pvico/RX-Dual-Power/Additional Documents/img/PCB Design Bottom.png

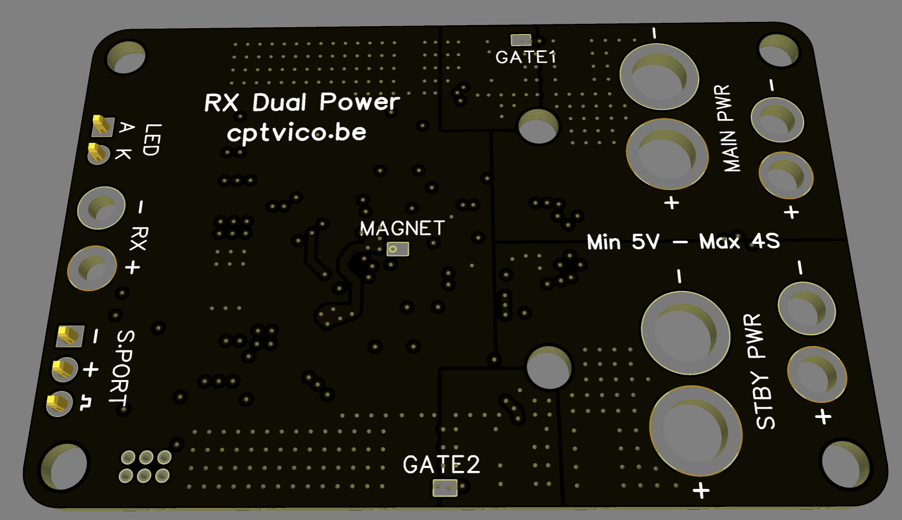
Additional Documents/img/PCB Design Bottom.png
