pvico/RX-Dual-Power/Additional Documents/img/PCB Design Top.png

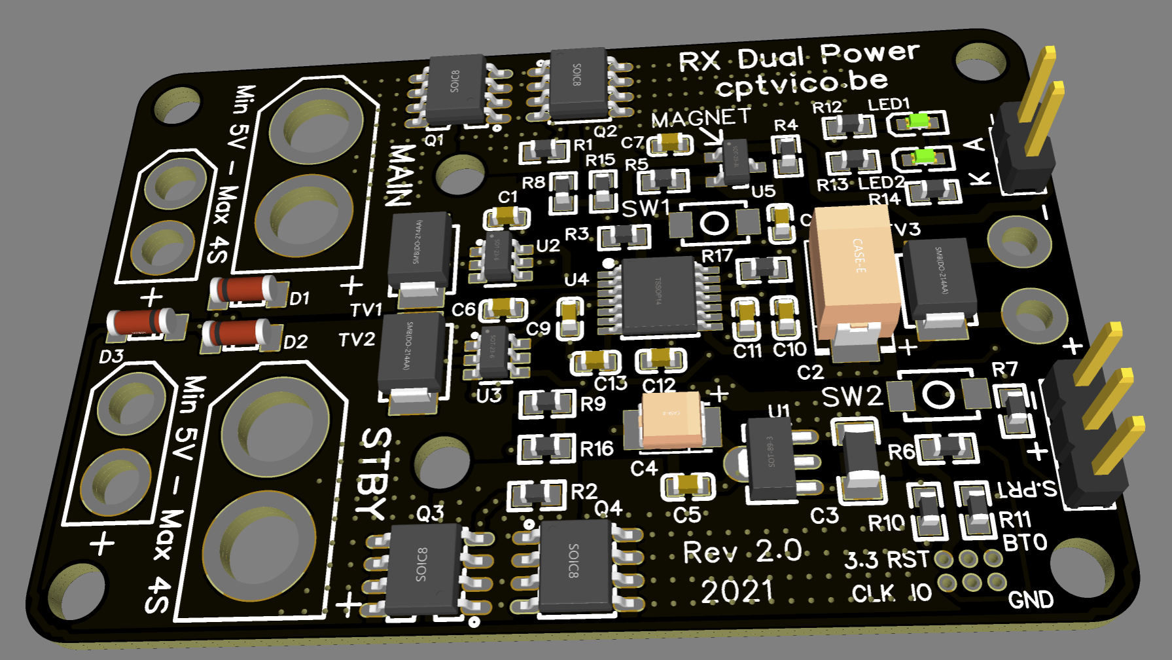
Additional Documents/img/PCB Design Top.png
