pvico/RX-Dual-Power/Additional Documents/img/RX Dual Power Back.jpg

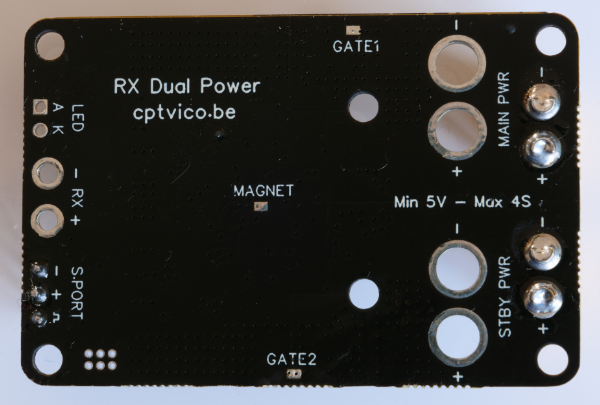
Additional Documents/img/RX Dual Power Back.jpg
