pvico/RX-Dual-Power/TODO.md

# TODO

- Configuration programming through usart
- Organize README and move part of it to wiki (https://guides.github.com/features/wikis/)

### Optional

- UART auto baudrate
- Other protocols:
    - SBUS2 (Futaba)
    - X-BUS (Spektrum)
    - M-LINK (Multiplex)
    - EX Bus (Jeti)
    - iBUS (FlySky)
