pvico/RX-Dual-Power/RISK-ANALYSIS.md

# TBD

## Electronics risks

## Software risks
