pvico/RX-Dual-Power/Additional Documents/pdf/Schematic.pdf

# 3.3V Regulator

Battery/BEC Connectors | Switches & Driver

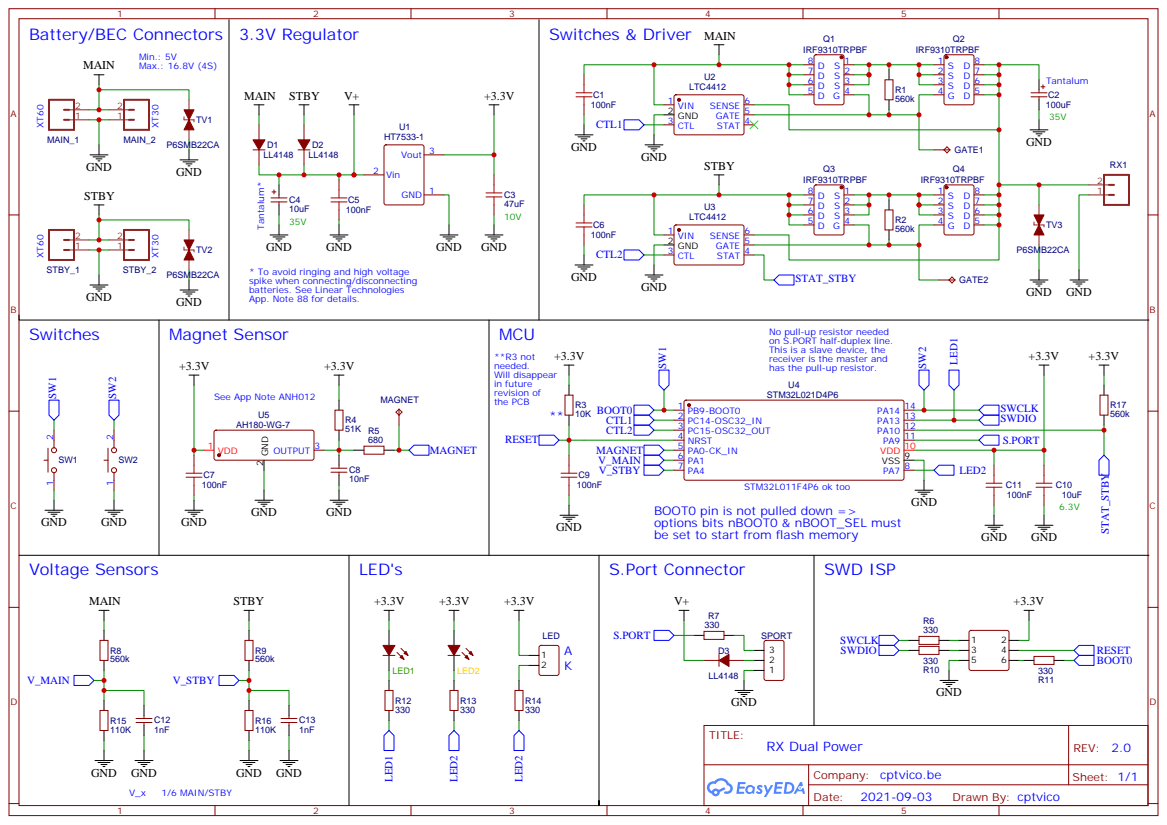
[picture p8: page 1]

* To avoid ringing and high voltage
spike when connecting/disconnecting
batteries. See Linear Technologies
App. Note 88 for details.

No pull-up resistor needed
on S.PORT half-duplex line.
This is a slave device, the
receiver is the master and
has the pull-up resistor.
STM32L021D4P6

MAGNET See App Note ANH012

BOOT0 pin is not pulled down =>
options bits nBOOT0 & nBOOT_SEL must
be set to start from flash memory
