pvico/RX-Dual-Power/Core/Inc/main.h

#define SW1_Pin LL_GPIO_PIN_9
#define SW1_GPIO_Port GPIOB
#define CTL1_Pin LL_GPIO_PIN_14
#define CTL1_GPIO_Port GPIOC
#define CTL2_Pin LL_GPIO_PIN_15
#define CTL2_GPIO_Port GPIOC
#define MAGNET_Pin LL_GPIO_PIN_0
#define MAGNET_GPIO_Port GPIOA
#define MAGNET_EXTI_IRQn EXTI0_1_IRQn
#define V_MAIN_Pin LL_GPIO_PIN_1
#define V_MAIN_GPIO_Port GPIOA
#define V_STBY_Pin LL_GPIO_PIN_4
#define V_STBY_GPIO_Port GPIOA
#define LED2_Pin LL_GPIO_PIN_7
#define LED2_GPIO_Port GPIOA
#define S_PORT_Pin LL_GPIO_PIN_9
#define S_PORT_GPIO_Port GPIOA
#define STAT_STBY_Pin LL_GPIO_PIN_10
#define STAT_STBY_GPIO_Port GPIOA
#define LED1_Pin LL_GPIO_PIN_13
#define LED1_GPIO_Port GPIOA
#define SW2_Pin LL_GPIO_PIN_14
#define SW2_GPIO_Port GPIOA
#define NVIC_PRIORITYGROUP_0         ((uint32_t)0x00000007) /*!< 0 bit  for pre-emption priority,
#define NVIC_PRIORITYGROUP_1         ((uint32_t)0x00000006) /*!< 1 bit  for pre-emption priority,
#define NVIC_PRIORITYGROUP_2         ((uint32_t)0x00000005) /*!< 2 bits for pre-emption priority,
#define NVIC_PRIORITYGROUP_3         ((uint32_t)0x00000004) /*!< 3 bits for pre-emption priority,
#define NVIC_PRIORITYGROUP_4         ((uint32_t)0x00000003) /*!< 4 bits for pre-emption priority,
