pvico/RX-Dual-Power/Inc/main_loop.h

//######################################################################################
// main_loop.h
// Main loop code, executes in an infinite loop after initialization
//
// Philippe Vico - 2021
//######################################################################################
 

#ifndef BF39E1DF_84AD_43F1_B73F_682AE7BE173E
#define BF39E1DF_84AD_43F1_B73F_682AE7BE173E


void main_loop();


#endif /* BF39E1DF_84AD_43F1_B73F_682AE7BE173E */
