pvico/RX-Dual-Power/Inc/exbus.h

//######################################################################################
// exbus.h
// Telemetry interface for EX Bus protocol (Jeti)
//
// Philippe Vico - 2021
//######################################################################################
 
 
#ifndef BC8CD575_174A_434F_92E2_CE01267D538C
#define BC8CD575_174A_434F_92E2_CE01267D538C


#include "main.h"
#include "initialize.h"


// FUTURE DEV



#endif /* BC8CD575_174A_434F_92E2_CE01267D538C */
