pvico/RX-Dual-Power/Src/exbus.c

//######################################################################################
// exbus.c
// Telemetry interface for EX Bus protocol (Jeti)
//
// Philippe Vico - 2021
//######################################################################################
 
 
#include "exbus.h"


// FUTURE DEV




//############################### Local helper functions ###############################
 
//######################################################################################
 
 
//################################## Public functions ##################################
 
//######################################################################################
 
 
//################################ Callback functions ##################################
 
//######################################################################################
