pvico/RX-Dual-Power/Src/ibus.c

//######################################################################################
// ibus.c
// Telemetry interface for X-BUS protocol (Spektrum)
//
// Philippe Vico - 2021
//######################################################################################
 
 
#include "ibus.h"


// FUTURE DEV




//############################### Local helper functions ###############################
 
//######################################################################################
 
 
//################################## Public functions ##################################
 
//######################################################################################
 
 
//################################ Callback functions ##################################
 
//######################################################################################
