pvico/RX-Dual-Power/Inc/system_clock.h

//######################################################################################
// system_clock.h
// Initialization of the system clocks
//
// Philippe Vico - 2021
//######################################################################################


#ifndef B3B07BC2_B140_48BF_953B_561AC0EC74BB
#define B3B07BC2_B140_48BF_953B_561AC0EC74BB


void init_system_clock();


#endif /* B3B07BC2_B140_48BF_953B_561AC0EC74BB */
