pvico/RX-Dual-Power/Src/m-link.c

//######################################################################################
// m-link.c
// Telemetry interface for M-LINK protocol (Multpiplex)
//
// Philippe Vico - 2021
//######################################################################################
 
 
#include "m-link.h"


// FUTURE DEV




//############################### Local helper functions ###############################
 
//######################################################################################
 
 
//################################## Public functions ##################################
 
//######################################################################################
 
 
//################################ Callback functions ##################################
 
//######################################################################################
