pvico/RX-Dual-Power/Src/sbus2.c

//######################################################################################
// sbus2.c
// Telemetry interface for SBUS2 protocol (Futaba)
//
// Philippe Vico - 2021
//######################################################################################
 
 
#include "sbus2.h"


// FUTURE DEV




//############################### Local helper functions ###############################
 
//######################################################################################
 
 
//################################## Public functions ##################################
 
//######################################################################################
 
 
//################################ Callback functions ##################################
 
//#######################################################################################
