pvico/RX-Dual-Power/Src/system_clock.c

//######################################################################################
// system_clock.c
// Initialization of the system clocks
//
// Philippe Vico - 2021
//######################################################################################


#include "system_clock.h"
#include "main.h"


//############################### Local helper functions ###############################

void init_system_clock() {
  LL_FLASH_SetLatency(LL_FLASH_LATENCY_0);
  while(LL_FLASH_GetLatency()!= LL_FLASH_LATENCY_0) {}
  LL_PWR_SetRegulVoltageScaling(LL_PWR_REGU_VOLTAGE_SCALE1);
  LL_RCC_HSI_Enable();

   /* Wait till HSI is ready */
  while(LL_RCC_HSI_IsReady() != 1) {}
  LL_RCC_HSI_SetCalibTrimming(16);
  LL_RCC_PLL_ConfigDomain_SYS(LL_RCC_PLLSOURCE_HSI, LL_RCC_PLL_MUL_3, LL_RCC_PLL_DIV_3);
  LL_RCC_PLL_Enable();

   /* Wait till PLL is ready */
  while(LL_RCC_PLL_IsReady() != 1) {}
  LL_RCC_SetAHBPrescaler(LL_RCC_SYSCLK_DIV_1);
  LL_RCC_SetAPB1Prescaler(LL_RCC_APB1_DIV_1);
  LL_RCC_SetAPB2Prescaler(LL_RCC_APB2_DIV_1);
  LL_RCC_SetSysClkSource(LL_RCC_SYS_CLKSOURCE_PLL);

   /* Wait till System clock is ready */
  while(LL_RCC_GetSysClkSource() != LL_RCC_SYS_CLKSOURCE_STATUS_PLL) {}

  LL_Init1msTick(16000000);

  LL_SetSystemCoreClock(16000000);
  LL_RCC_SetUSARTClockSource(LL_RCC_USART2_CLKSOURCE_PCLK1);
}
