pvico/RX-Dual-Power/Inc/system.h

//######################################################################################
// system.h
// Determines power off activation and some timing functiopns
//
// Philippe Vico - 2021
//######################################################################################


#ifndef BD480334_5D6E_4ECD_90B7_42EA759C3902
#define BD480334_5D6E_4ECD_90B7_42EA759C3902


#include <stdbool.h>


void system_loop();
bool is_in_first_16s_after_startup();
bool is_in_first_32s_after_startup();
bool rough_second_tick();
bool rough_quarter_second_tick();


#endif /* BD480334_5D6E_4ECD_90B7_42EA759C3902 */
