pvico/RX-Dual-Power/Inc/timer.h

//######################################################################################
// timer.h
// Timer initializaton
//
// Philippe Vico - 2021
//######################################################################################


#ifndef FC128E11_9435_48CF_9FB7_F27F441DEDFA
#define FC128E11_9435_48CF_9FB7_F27F441DEDFA


void init_timer();


#endif /* FC128E11_9435_48CF_9FB7_F27F441DEDFA */
