pvico/RX-Dual-Power/Inc/watchdog.h

//######################################################################################
// watchdog.c
// Initialization of watchdog
//
// Philippe Vico - 2021
//######################################################################################


#ifndef E8358196_CFBC_4A72_951B_5523CD6C785E
#define E8358196_CFBC_4A72_951B_5523CD6C785E


void init_watchdog();


#endif /* E8358196_CFBC_4A72_951B_5523CD6C785E */
