pvico/RX-Dual-Power/Inc/adc_dma.h

//######################################################################################
// adc_dma.h
// Initialization and interrupt callback functions for ADC and DMA
//
// Philippe Vico - 2021
//######################################################################################


#ifndef A761D1B1_EFD4_4E28_91EE_EBCC86E26999
#define A761D1B1_EFD4_4E28_91EE_EBCC86E26999


void init_adc_dma();

void dma_callback();
void adc_callback();


#endif /* A761D1B1_EFD4_4E28_91EE_EBCC86E26999 */
