pvico/RX-Dual-Power/Inc/button.h

//######################################################################################
// button.h
// Intitialization and loop code for buttons and managament of button state 
//
// Philippe Vico - 2021
//######################################################################################


#ifndef A61822EC_01F4_46DB_9C40_C645C11613D2
#define A61822EC_01F4_46DB_9C40_C645C11613D2

#include "stdbool.h"
#include "stdint.h"
#include "initialize.h"

#define BUTTON_DEBOUNCE_DELAY_MILLIS    10
#define BUTTON_DOUBLE_ACTIVATION_MILLIS    2000

typedef enum button_states {BUTTON_DEPRESSED, BUTTON_NOT_DEPRESSED} button_state;
typedef enum {SW1, SW2} button_name;


typedef struct {
    button_state debounced_state;
    uint16_t depressed_loop_counter;
    uint16_t not_depressed_loop_counter;
    bool (*is_depressed)(void);
} button;


initialization_result init_buttons();

void button_loop();

bool is_button_dual_activation_active();

#endif /* A61822EC_01F4_46DB_9C40_C645C11613D2 */
