pvico/RX-Dual-Power/Inc/initialize.h

//######################################################################################
// initialize.c
// All initialization before entering the main loop
//
// Philippe Vico - 2021
//######################################################################################


#ifndef F5452735_251A_4D3E_9219_05E1BA3BC45C
#define F5452735_251A_4D3E_9219_05E1BA3BC45C


typedef enum initialization_results {INITIALIZE_OK, INITIALIZE_NOT_OK} initialization_result;


void initialize();


#endif /* F5452735_251A_4D3E_9219_05E1BA3BC45C */
