pvico/RX-Dual-Power/Inc/m-link.h

//######################################################################################
// m-link.h
// Telemetry interface for M-LINK protocol (Multpiplex)
//
// Philippe Vico - 2021
//######################################################################################
 
 
#ifndef B310D826_0E92_42FC_8EA0_584E89FA15D1
#define B310D826_0E92_42FC_8EA0_584E89FA15D1


#include "main.h"
#include "initialize.h"


// FUTURE DEV



#endif /* B310D826_0E92_42FC_8EA0_584E89FA15D1 */
