pvico/RX-Dual-Power/Inc/sbus2.h

//######################################################################################
// sbus2.h
// Telemetry interface for SBUS2 protocol (Futaba)
//
// Philippe Vico - 2021
//######################################################################################


#ifndef A1B88089_BBCF_419B_B50B_0AED3E8D1A82
#define A1B88089_BBCF_419B_B50B_0AED3E8D1A82

#include "main.h"
#include "initialize.h"


// FUTURE DEV



#endif /* A1B88089_BBCF_419B_B50B_0AED3E8D1A82 */
