pvico/RX-Dual-Power/(commit log)

2021-08-29 Testing ADC
2021-08-30 Voltage sensors
2021-08-31 led states
2021-08-31 led states corrected
2021-08-31 Corrected magnet logic
2021-09-01 stop mode power optimized
2021-09-01 Corrected LED when magnet present
    [button.c, button.h, debug_console.c, debug_console.h, initialize.c, magnet.c, magnet.h, main_loop.c]
2021-09-03 Schematic added
2021-09-03 LED inirtial state
2021-09-06 Switch debouncing correction
2021-09-07 README + power_source (WIP)
2021-09-08 power_source (WIP) and initialization
2021-09-08 config.h and power_source (WIP)
2021-09-08 power_source (WIP)
2021-09-09 Voltage sensor averaging (WIP)
2021-09-09 voltage sensor averaging ok
2021-09-09 switching logic (WIP)
2021-09-10 Refactored led.c
2021-09-10 LED signalling; refactorin; switching not correct
    [button.c, button.h, debug_console.c, main_loop.c, power_source.c, power_source.h, switching_logic.c, system.c]
2021-09-10 Watchdog timer
2021-09-11 Switching logic ansd refactoring
2021-09-11 Magnet present led corrected
    [led.c, magnet.c, magnet.h]
2021-09-12 Power source status logic
2021-09-12 Corrected bug: brief power off if disc. after 32"
    [debug_console.c, debug_console.h, main_loop.c, power_source.c, switching_logic.c, system.c, system.h]
2021-09-12 Corrected bug spurious re-power up from SW1
    [RX-Dual-Power.ioc, config.h, main.h, switching_logic.c]
2021-09-12 Changed LED signalling
2021-09-17 Working simplified HAL code for ADC
2021-09-18 uart now in own source files
2021-09-18 timer now in own code files
2021-09-18 ADC regulator shutdown before stop mode
2021-09-20 power sources initilaization from eeprom
2021-09-21 System clock in all files, re-config UART (WIP)
